Mukesh12mandal/ORION-robotic-arm/images/Motor_driver.jpg

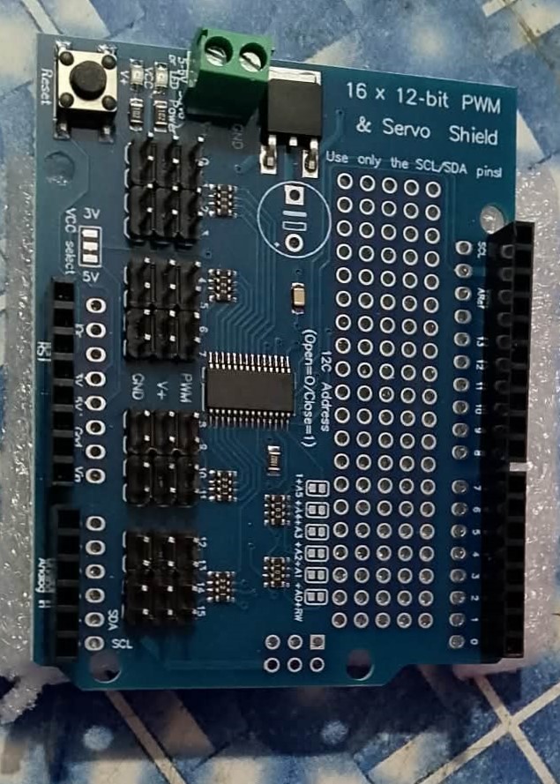
images/Motor_driver.jpg
