Mukesh12mandal/ORION-robotic-arm/(commit log)

2026-09-23 docs: finalize ORION architecture, schematics, and README documentation
2026-09-23 Update README with gripper validation link
    Added a link for gripper validation in the README.
